dchwebb/PlayDice/Hardware/PlayDice.kicad_pcb

## KiCad design Hardware/PlayDice.kicad_pcb (2021-09-21)

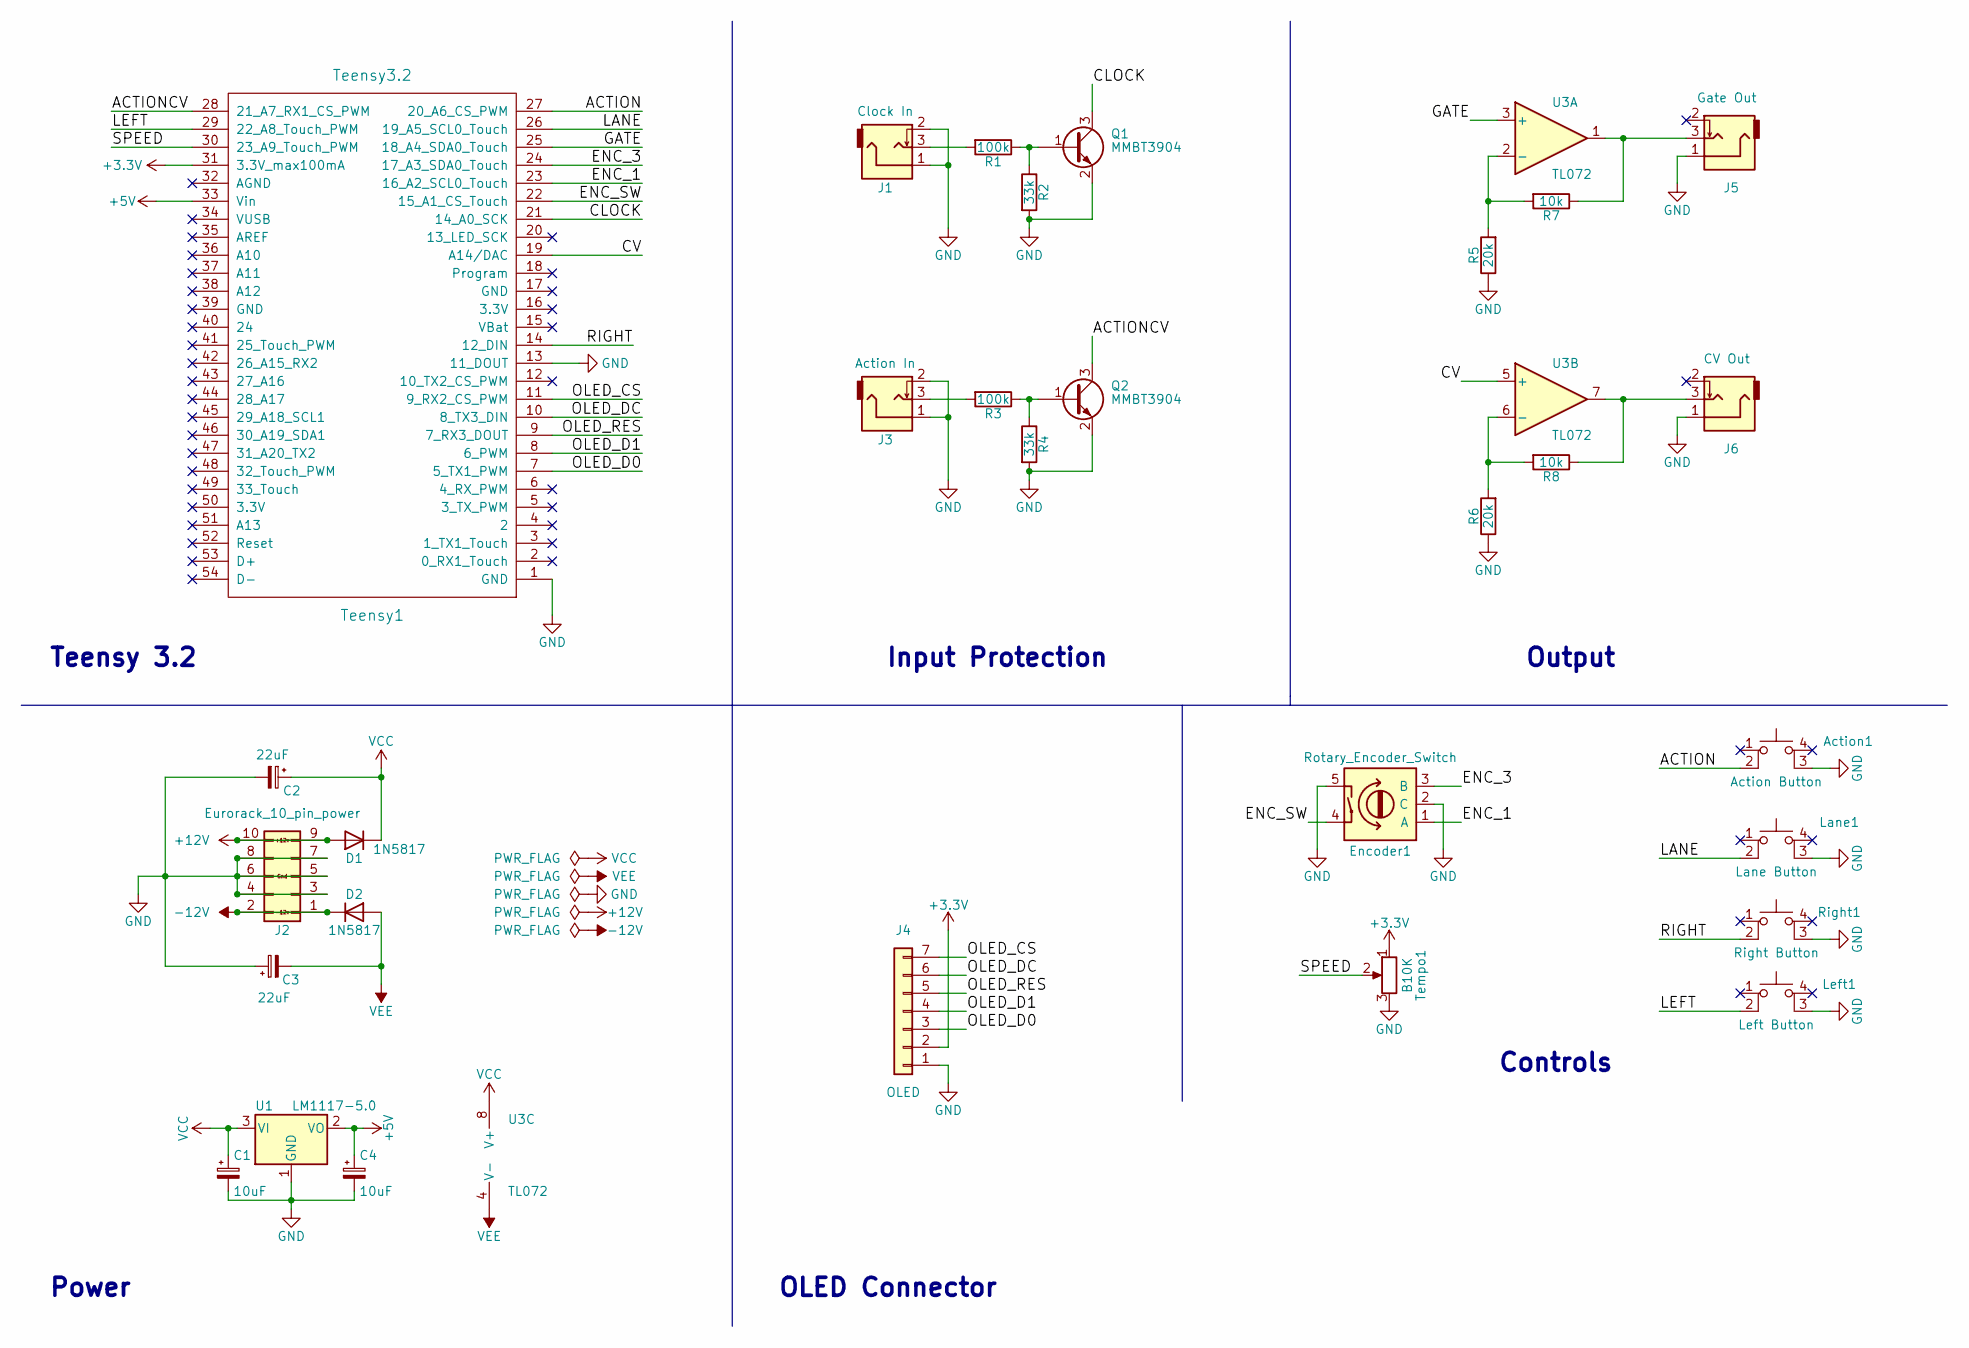
[picture p1: schematic PlayDice.kicad_sch, Play Dice]

Parts:
Action1: Action Button; SW_MEC_5GTH9
C1, C4: 10uF; C_0805_2012Metric_Pad1.18x1.45mm_HandSolder
C2, C3: 22uF; CP_Radial_D5.0mm_P2.00mm
D1, D2: 1N5817; D_DO-41_SOD81_P7.62mm_Horizontal
Encoder1: Rotary_Encoder_Switch
J1: Clock In; THONKICONN_hole
J2: Eurorack_10_pin_power; Eurorack_10_pin_header
J3: Action In; THONKICONN_hole
J4: OLED; OLED_7_Pin_Connector
J5: Gate Out; THONKICONN_hole
J6: CV Out; THONKICONN_hole
Lane1: Lane Button; SW_MEC_5GTH9
Left1: Left Button; SW_MEC_5GTH9
Q1, Q2: MMBT3904; SOT-23
R1, R3: 100k; R_0805_2012Metric_Pad1.20x1.40mm_HandSolder
R2, R4: 33k; R_0805_2012Metric_Pad1.20x1.40mm_HandSolder
R5, R6: 20k; R_0805_2012Metric_Pad1.20x1.40mm_HandSolder
R7, R8: 10k; R_0805_2012Metric_Pad1.20x1.40mm_HandSolder
Right1: Right Button; SW_MEC_5GTH9
Teensy1: Teensy3.2; Teensy30_31_32_LC
Tempo1: B10K; Potentiometer_Alps_RK09K_Horizontal
U1: LM1117-5.0; SOT-223
U3: TL072; SOIC-8_3.9x4.9mm_Pitch1.27mm

Connections:
+3V3: J4.2, Teensy1.31 (3.3V_max100mA), Tempo1.1
+5V: C4.1, Teensy1.33 (Vin), U1.2 (VO)
+12V: D1.2 (A), J2.9, J2.10
-12V: D2.1 (K), J2.1, J2.2
/ACTION: Action1.2, Teensy1.27 (20_A6_CS_PWM)
/ACTIONCV: Q2.3 (C), Teensy1.28 (21_A7_RX1_CS_PWM)
/CLOCK: Q1.3 (C), Teensy1.21 (14_A0_SCK)
/CV: Teensy1.19 (A14/DAC), U3.5 (+)
/ENC_1: Encoder1.1 (A), Teensy1.23 (16_A2_SCL0_Touch)
/ENC_3: Encoder1.3 (B), Teensy1.24 (17_A3_SDA0_Touch)
/ENC_SW: Encoder1.4, Teensy1.22 (15_A1_CS_Touch)
/GATE: Teensy1.25 (18_A4_SDA0_Touch), U3.3 (+)
/LANE: Lane1.2, Teensy1.26 (19_A5_SCL0_Touch)
/LEFT: Left1.2, Teensy1.29 (22_A8_Touch_PWM)
/OLED_CS: J4.7, Teensy1.11 (9_RX2_CS_PWM)
/OLED_D0: J4.3, Teensy1.7 (5_TX1_PWM)
/OLED_D1: J4.4, Teensy1.8 (6_PWM)
/OLED_DC: J4.6, Teensy1.10 (8_TX3_DIN)
/OLED_RES: J4.5, Teensy1.9 (7_RX3_DOUT)
/RIGHT: Right1.2, Teensy1.14 (12_DIN)
/SPEED: Teensy1.30 (23_A9_Touch_PWM), Tempo1.2
GND: Action1.3 (K), C1.2, C2.2, C3.1, C4.2, Encoder1.2 (C), Encoder1.5, J1.1, J1.2, J2.3, J2.4, J2.5, J2.6, J2.7, J2.8, J3.1, J3.2, J4.1, J5.1, J6.1, Lane1.3 (K), Left1.3 (K), Q1.2 (E), Q2.2 (E), R2.2, R4.2, R5.1, R6.1, Right1.3 (K), Teensy1.1 (GND), Teensy1.13 (11_DOUT), Tempo1.3, U1.1 (GND)
unnamed: J1.3, R1.2
unnamed: J3.3, R3.2
unnamed: J5.3, R7.1, U3.1
unnamed: J6.3, R8.1, U3.7
unnamed: Q1.1 (B), R1.1, R2.1
unnamed: Q2.1 (B), R3.1, R4.1
unnamed: R5.2, R7.2, U3.2 (-)
unnamed: R6.2, R8.2, U3.6 (-)
VCC: C1.1, C2.1, D1.1 (K), U1.3 (VI), U3.8 (V+)
VEE: C3.2, D2.2 (A), U3.4 (V-)

Notes on the sheet:
Teensy 3.2
Power
OLED Connector
Input Protection
Controls
Output

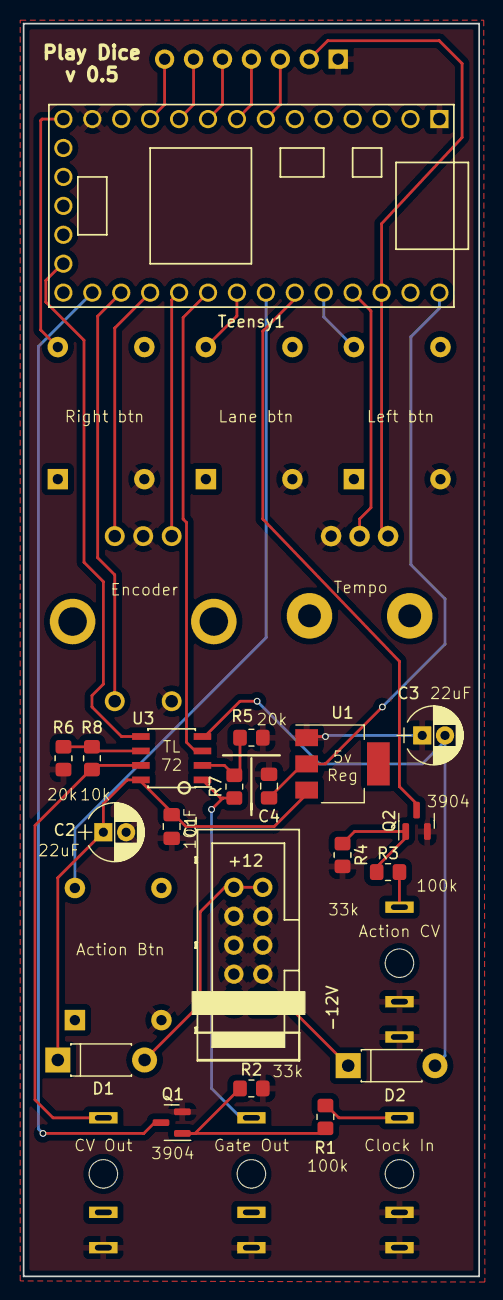
[picture p2: board PlayDice.kicad_pcb from above]

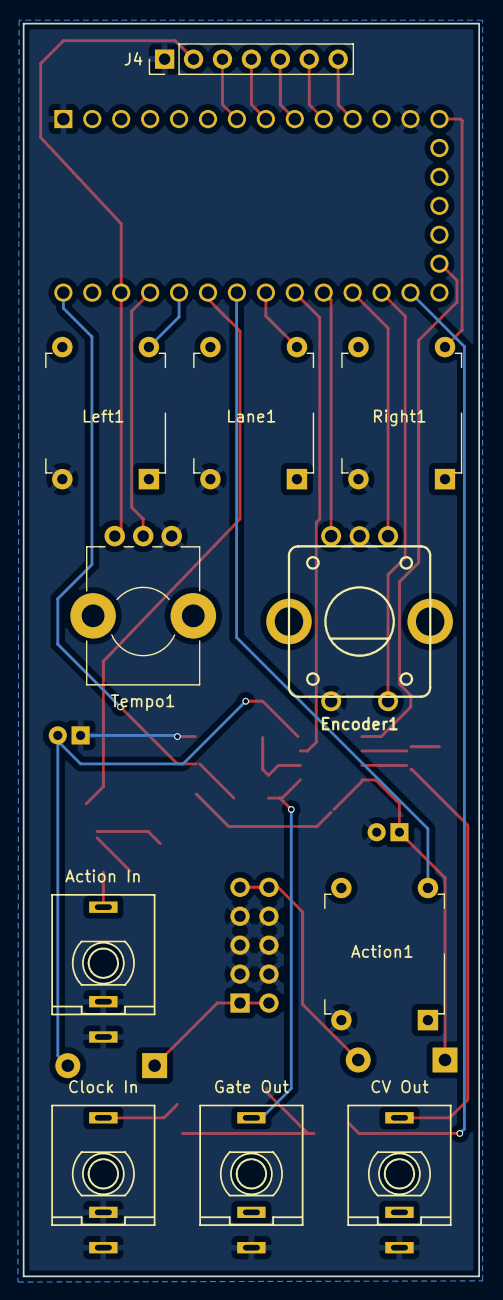
[picture p3: board PlayDice.kicad_pcb from below]

Board: 2 copper layers, 40.0 x 110.0 mm, 31 parts (11 on the bottom side), 32 nets.
