dchwebb/PlayDice/(commit log)

2018-04-14 Optimisations to I2C display routines
2018-04-14 Seq looping and action button
2018-04-25 Button pins moved to free SPI connections
2018-05-01 CV Stutter and SPI implemented
2018-07-08 KiCad files
2018-07-10 Moved Teensy PIns for PCB layout
2018-07-10 Added Kicad files (again)
2018-07-11 Final pin reassignments for PCB
2018-07-14 Autosave implemented and cleaned up noise mode
    [DisplayHandler.h, PlayDice.ino, Settings.h, SetupFunctions.h]
2018-07-18 Bug fixes and PCB updates
    [PlayDice-B.Cu.gbr, PlayDice-B.Mask.gbr, PlayDice-B.SilkS.gbr, PlayDice-Edge.Cuts.gbr, PlayDice-F.Cu.gbr, PlayDice-F.Mask.gbr, PlayDice-F.SilkS.gbr, PlayDice-NPTH.drl]
2018-07-18 Basic pitched CV mode
    [PlayDice.kicad_pcb]
2018-07-20 Submenu functionality and some pitch mode quantising
2018-07-21 PCB fixed transistor connections; added basic handling for scale quantisation
    [PlayDice-B.Cu.gbr, PlayDice-B.Mask.gbr, PlayDice-B.SilkS.gbr, PlayDice-Edge.Cuts.gbr, PlayDice-F.Cu.gbr, PlayDice-F.Mask.gbr, PlayDice-F.SilkS.gbr, PlayDice-NPTH.drl]
2018-09-30 Bug Fixes and panel updates
    [Panel.kicad_pcb, PlayDice.kicad_pcb, PlayDice.sch]
2018-10-03 Clock fixes, better debugging
    [ClockHandler.h, DisplayHandler.h, PlayDice.ino, Settings.h, SetupFunctions.h]
2018-10-03 Fixed random error; added trigger mode for gate sequence
    [PlayDice.ino, Settings.h, SetupFunctions.h]
2018-10-05 Added CV offset for calibration; basic pitch and scale quantising
2018-10-08 Bug fixes and code tidy up
    [DisplayHandler.h, PlayDice.ino, Settings.h, SetupFunctions.h]
2018-10-09 Added per sequence gate/trigger and pitch/cv options
2018-10-30 Various bug fixes - mainly around quantising
    [DisplayHandler.h, PlayDice.ino, Settings.h, SetupFunctions.h]
2018-11-30 Various code tidy-ups. Added configuration option for encoder direction. ADded new panel gerbers
    [Panel-B.Cu.gbr, Panel-B.Mask.gbr, Panel-B.SilkS.gbr, Panel-Edge.Cuts.gbr, Panel-F.Cu.gbr, Panel-F.Mask.gbr, Panel-F.SilkS.gbr, Panel-NPTH.drl]
2021-09-18 Removed bu files
    [PlayDice.kicad_pcb, PlayDice.sch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]
2021-09-19 Revised Panel; started transferring Kicad files to v 5.99
    [Panel-B.Cu.gbr, Panel-B.Mask.gbr, Panel-B.SilkS.gbr, Panel-Edge.Cuts.gbr, Panel-F.Cu.gbr, Panel-F.Mask.gbr, Panel-F.SilkS.gbr, Panel-NPTH.drl]
2021-09-21 Updated to black and silver colour scheme; Transferred pcb and panel to Kicad 5.99
    [Panel-B.Cu.gbr, Panel-B.Mask.gbr, Panel-B.SilkS.gbr, Panel-B_Cu.gbr, Panel-B_Mask.gbr, Panel-B_Silkscreen.gbr, Panel-Edge.Cuts.gbr, Panel-Edge_Cuts.gbr]
2021-09-23 Panel pcb gerbers prepared for production
    [Panel-B_Cu.gbr, Panel-B_Mask.gbr, Panel-B_Silkscreen.gbr, Panel-Edge_Cuts.gbr, Panel-F_Cu.gbr, Panel-F_Mask.gbr, Panel-F_Silkscreen.gbr, Panel-NPTH.drl]
